NilsBade/AntRig-Measurement-System/PythonChamberApp/figures/Readme/AntRig_ChamberControlTab.png

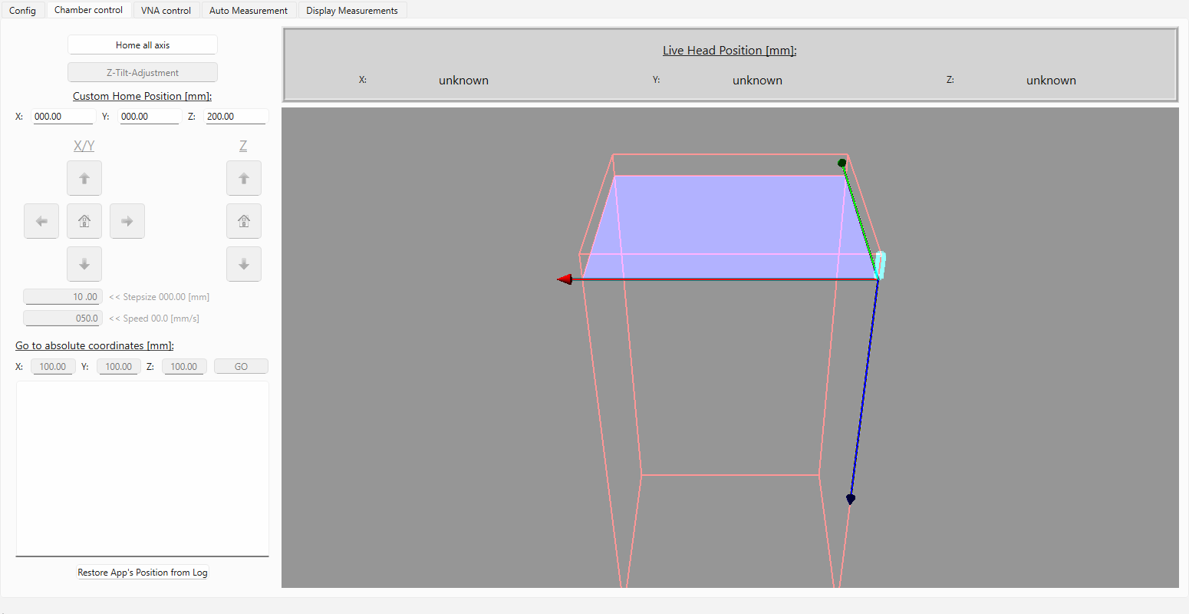
PythonChamberApp/figures/Readme/AntRig_ChamberControlTab.png
