NilsBade/AntRig-Measurement-System/PythonChamberApp/figures/Readme/AntRig_ConfigTab.png

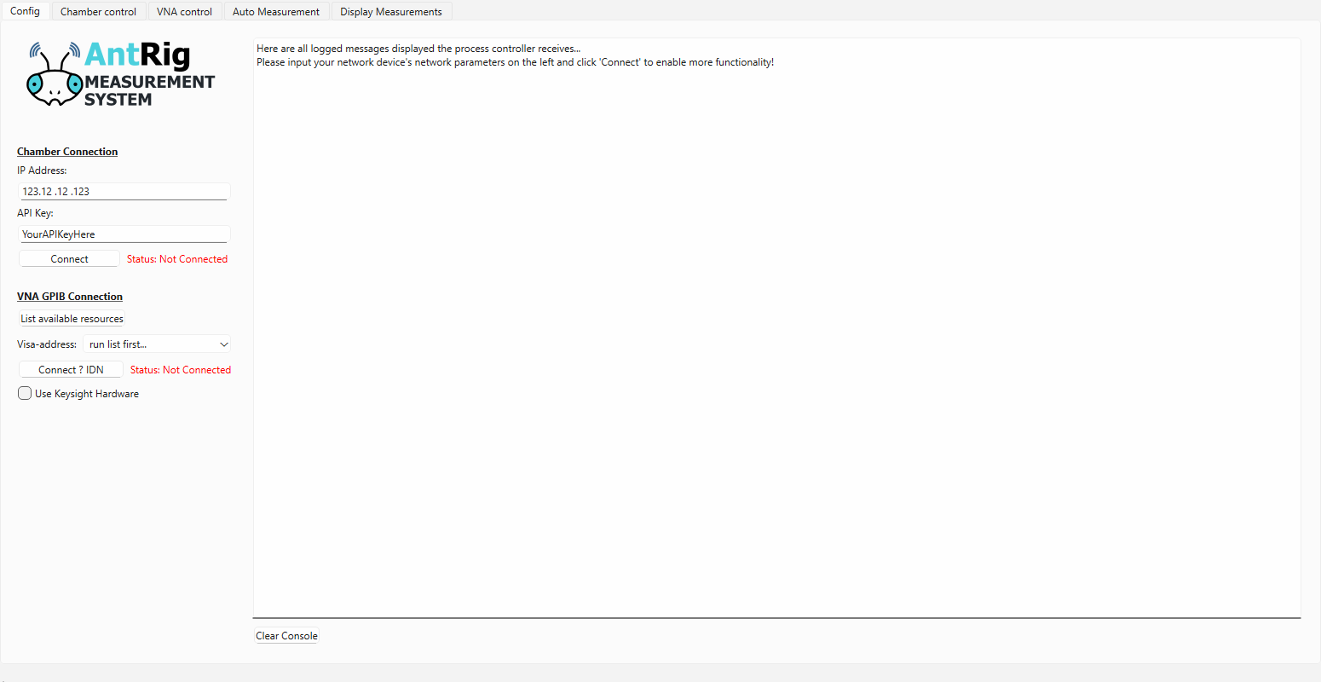
PythonChamberApp/figures/Readme/AntRig_ConfigTab.png
