NilsBade/AntRig-Measurement-System/PythonChamberApp/figures/Readme/AntRig_VNAControlTab.png

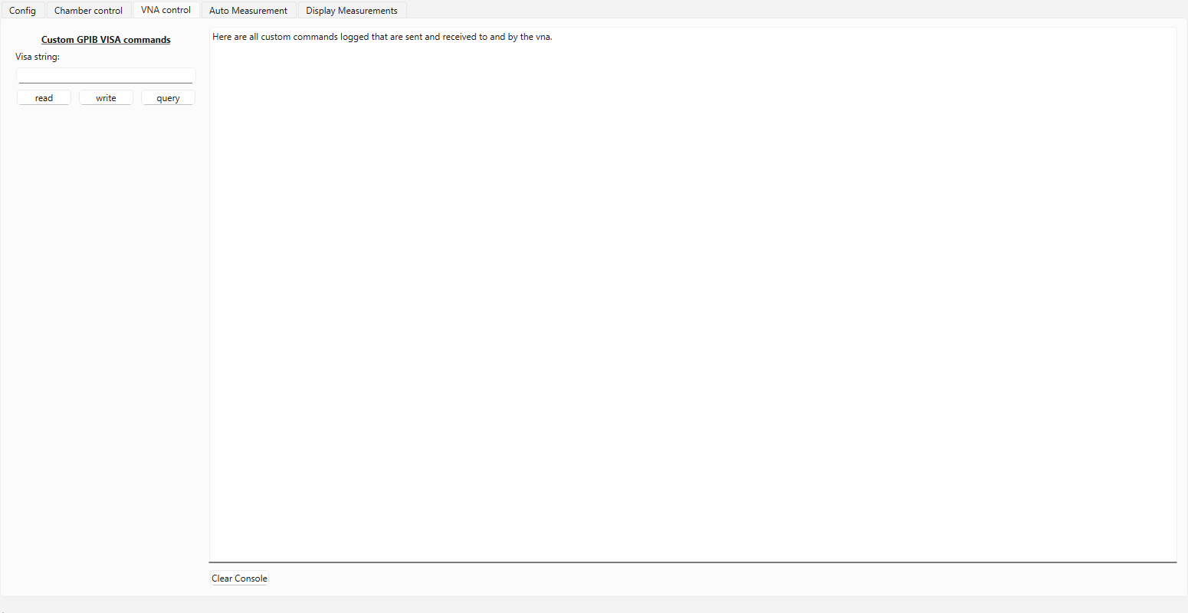
PythonChamberApp/figures/Readme/AntRig_VNAControlTab.png
