NilsBade/AntRig-Measurement-System/docs/BOM/AntRig_Chamber_V1_BOM.xlsx

Sheet: Absorbersurface Calc
Absorber-Installation-Area
 | Position | Number | Area Height [mm] | Area Width [mm] | Total Area [cm^2] |  | For highly directive antenne most crucial
 | Top/Ceiling | 1 | 640 | 640 | 4096
 | Base plate (AUT) | 1 | 530 | 530 | 2809 | *Absorbers must be laid out around AUT
 | X-gantry downside | 1 | 620 | 40 | 248
 | Top L/R | 2 | 230 | 660 | 3036
 | Top Front/Rear | 2 | 230 | 640 | 2944
 | Mid L/R | 2 | 560 | 620 | 6944
 | Mid Front | 1 | 560 | 640 | 3584
 | Bottom L/R | 2 | 560 | 620 | 6944
 | Bottom Front | 1 | 560 | 640 | 3584
 | Rear Panels | 4 | 560 | 300 | 6720
 | Sum of all Areas |  |  |  | 40909 | = [m^2] => | 4.0909

Sheet: Enclosure Order+Postprocessing
Link DXF SVG converter: |  | https://convertio.co/de/dxf-svg/
Postprocessing: |  | Lasercutter, Trotec Speedy SP500 |  | Working Area (W x D): 1245 x 710 [mm2] // Load Area (W x D): 1420 x 820 [mm2]
Panel Dimensions
Height [mm] | Width [mm] | Number used | (Docu) Part Name | Part Location(s)
678 | 710 | 1 | 1* Deckel/Top | Top
326.5 | 628 | 1 | 1* Back Top | Back
541 | 299 | 4 | 4* Back Part (1* modified HF Kabel) | Back
283 | 785 | 2 | 2* SidePanel L/R top | Left/Right
597 | 698 | 4 | 4* SidePanel L/R bottom | Left/Right
283 | 710 | 1 | 1* FrontPanel top | Front
597 | 710 | 2 | 2* FrontPanel bottom | Front
200 | 655 | 1 | 1* E-Panel | Elektronik Panel
Ordering |  |  |  | Postprocessing
Order: PLEXIGLAS® GS orange 3mm (https://www.plattenzuschnitt24.de/Plexiglas-Orange-2H02-GT-3mm.html) |  |  | Parts-Output per panel | SVG File names (Filelocation: *\CAD_and_Manufacturing\Enclosure_LaserCut_SVGs)
565 | 620 | 2 | 2*BackPanel (incl. 1* HF Anpassung)] | 2 SVGs: "1xBackUntenNormal_1xBackUntenHF_565x620","2xBackUntenNormal_565x620"
600 | 805 | 1 | 2* SidePanel L/R top | 1 SVG: "2xSidePanel_Top_LR_600x805"
720 | 1230 | 2 | 2* SidePlanel L/R bottom | 2 SVGs: "2xSidePanel_Bottom_Left_720x1230","2xSidePanel_Bottom_Right_720x1230"
620 | 730 | 2 | 1* FrontPanel bottom | 2 SVGs: "1xFrontPanel_Bottom620_730","1xFrontPanel_Middle_620x730"
700 | 730 | 1 | 1* TopPanel/Ceiling | 1 SVG: "1xTopPanel_700x730"
350 | 650 | 1 | 1* RearPanel Top | 1 SVG: "1xRearTopPanel_350x650"
305 | 730 | 1 | 1* FrontPanel Top | 1 SVG: "1xFrontPanel_Top_305x730"
220 | 675 | 1 | 1* Electronics Panel (Rear) | 1 SVG: "1xElectronicsPanel_220x675"
[mm] | [mm] | number
Enclosure Total Area: | 4.96965 | [m^2]
Cost per m^2: | 68.75 | [€/m^2]
Total Cost: | 341.66 € | EURO

Sheet: RatRig Parts
Order, Feb 2024
 | Part | Number | Price p.P. | Entry Cost | Total Cost: | 782.94 € | Links
1 | ENDSTOP MODULE - HORIZONTAL LIMIT SWITCH ONLY | 4.00 | 1.04 € | 4.16 € |  |  | https://ratrig.com/electronics/probes-limit-switches/endstop-module-horizontal-limit-switch-only.html
2 | BLTOUCH V3.1 - GENUINE ANTCLABS AUTO BED LEVELING SENSOR | 1.00 | 45.00 € | 45.00 € |  |  | https://ratrig.com/bltouch-v3-1.html
3 | ALUMINIUM SPACER - 6MM | 15.00 | 0.25 € | 3.75 € |  |  | https://ratrig.com/aluminium-spacer-6mm.html
4 | BALL BEARING - 695-2RS | 12.00 | 0.79 € | 9.48 € |  |  | https://ratrig.com/ball-bearing-695-2rs.html
5 | BALL BEARING F688ZZ FLANGED 8 X 16 X 5 | 3.00 | 1.06 € | 3.18 € |  |  | https://ratrig.com/ball-bearing-f688zz.html
6 | BALL BEARING - F695ZZ | 24.00 | 1.06 € | 25.44 € |  |  | https://ratrig.com/ball-bearing-f695zz.html
7 | COUPLER - RIGID TYPE - BLACK 25*20MM - 5MM TO 8MM | 2.00 | 3.96 € | 7.92 € |  |  | https://ratrig.com/coupler-rigid-type-black-25-20mm-5mm-to-8mm.html
8 | Bed Plate - Cast tooling plate - Pre-Machined - 529*529*6mm | 1.00 | 132.92 € | 132.92 € |  |  | https://ratrig.com/bed-plate-cast-tooling-plate-pre-machined-multiple-sizes.html
9 | TIMING BELT - 2GT 9MM (BY THE METER) | 6.00 | 2.90 € | 17.40 € |  |  | https://ratrig.com/timing-belt-2gt-9mm-by-the-meter.html
10 | DOWEL PIN - 3.0MM X 35.0MM | 6.00 | 0.42 € | 2.52 € |  |  | https://ratrig.com/dowel-pin-3-0mm-x-35-0mm.html
11 | Lead Screw - TR8*8 Metric Acme Lead Screw - 1057mm | 2.00 | 31.64 € | 63.28 € |  |  | https://ratrig.com/acme-8mm-lead-screw.html
12 | MAGNET - 20 X 10 X 5MM - TWO HOLE (M3 COUNTERSINK SCREWS) | 2.00 | 2.11 € | 4.22 € |  |  | https://ratrig.com/magnet-20-x-10-x-5mm-two-hole-m3-countersink-screws.html
13 | Linear Rail - MGN15 500mm + MGN15C carriage | 2.00 | 36.00 € | 72.00 € |  |  | https://ratrig.com/hardware2/linear-rails/linear-rail-mgn15-mgn15c-carriage.html
14 | Linear Rail - MGN15 1000mm + 2 x MGN15C carriage | 3.00 | 76.77 € | 230.31 € |  |  | https://ratrig.com/hardware2/linear-rails/linear-rail-mgn15-2x-mgn15c-carriage-multiple-lengths.html
15 | MINI PRECISION SHIM - 8 X 5 X 1MM | 35.00 | 0.21 € | 7.35 € |  |  | https://ratrig.com/precision-mini-shim-8x5x1mm.html
16 | Nema 17 Stepper Motor - 48mm - 1.8degree/step, 76oz-in (LDO-42STH48-2504AC) + Cable 2000mm - 4 Conductor 24AWG - JST XH2.54 to JST PH6P (Nema 17 connector) | 4.00 | 17.42 € | 69.68 € |  |  | https://ratrig.com/nema-17-stepper-motor.html
17 | NYLON SPACER - 3MM X 7MM X 5MM | 20.00 | 0.05 € | 1.00 € |  |  | https://ratrig.com/nylon-spacer-3mm-x-7mm-x-5mm.html
18 | RAT RIG BI-MATERIAL LEAD SCREW DECOUPLER | 3.00 | 13.19 € | 39.57 € |  |  | https://ratrig.com/rat-rig-bi-material-lead-screw-decoupler.html
19 | STEEL BALL - 12MM - THREADED M5 | 10.00 | 1.12 € | 11.20 € |  |  | https://ratrig.com/steel-ball-12mm-threaded-m5.html
20 | Thrust Bearing F8-16M | 2.00 | 1.85 € | 3.70 € |  |  | https://ratrig.com/thrust-bearing-f8-16m.html
21 | TIMING PULLEY - 2GT (2MM) - 20 TOOTH - FOR 9MM BELT - 5MM BORE | 2.00 | 3.43 € | 6.86 € |  |  | https://ratrig.com/openbuilds-gt2-2mm-aluminum-timing-pulley-9mm.html
22 | RAT RIG V-CORE 3.1 - WIRING KIT 500 | 1.00 | 22.00 € | 22.00 € |  |  | https://ratrig.com/rat-rig-v-core-3-1-wiring-kit-500.html
23 |  |  | 0.00 € | 0.00 €

Sheet: ITEM Parts
Order, Feb 2024
 | Part | Number | Cost p.P. | Entry Cost | ITEM ID | Total Cost: | 1071.54 € | Links
1 | Universal-Halter | 6.00 | 0.66 € | 3.96 € | 0049452 |  |  | https://www.item24.com/de-de/universal-halter-8-schwarz-49452?velcro=false&fastMounting=true
2 | Befestigungssatz 8 für Lenk-/Bockrolle 140x110 | 12.00 | 1.44 € | 17.28 € | 0067018 |  |  | https://www.item24.com/de-de/befestigungssatz-8-fur-lenk-bockrolle-140x110-67018#description
3 | Winkelsatz 8 40x40 | 11.00 | 6.00 € | 66.00 € | 0041115 |  |  | https://www.item24.com/de-de/winkelsatz-8-40x40-41115
4 | Lenkrolle 140x110 | 4.00 | 38.59 € | 154.36 € | 0066718 |  |  | https://www.item24.com/de-de/lenkrolle-d100-doppelfeststeller-140x110-66718?esd=false
6 | Abdeckkappe 8 40x40 schwarz | 4.00 | 0.63 € | 2.52 € | 0002601 |  |  | https://www.item24.com/de-de/abdeckkappe-8-40x40-schwarz-2601?esd=false
7 | Abdeckkappe 8 80x40 schwarz | 4.00 | 1.04 € | 4.16 € | 0002602 |  |  | https://www.item24.com/de-de/abdeckkappe-8-80x40-schwarz-2602?esd=false
8 | Knotenblechsatz 8 40 120x120 90° | 13.00 | 11.76 € | 152.88 € | 0070802 |  |  | https://www.item24.com/de-de/knotenblechsatz-8-40-120x120-90-70802?outlet=false
9 | Knotenblechsatz 8 40 200x120 180° | 6.00 | 16.40 € | 98.40 € | 0070805 |  |  | https://www.item24.com/de-de/knotenblechsatz-8-40-200x120-180-70805?outlet=false
10 | Kabelführungsprofil 8 40x16 2000mm | 2.00 | 20.43 € | 40.86 € | 0065445 |  |  | https://www.item24.com/de-de/kabelfuhrungsprofil-8-40x16-grau-ahnlich-ral-7042-65444
11 | Nutenstein 8 Zn M3, verzinkt | 100.00 | 0.99 € | 99.00 € | 0037359 |  |  | https://www.item24.com/de-de/nutenstein-8-zn-m3-verzinkt-37359#technical-data
12 | Hammermutter 8 M6, verzinkt | 220.00 | 0.45 € | 99.00 € | 0062606 |  |  | https://www.item24.com/de-de/hammermutter-8-m6-verzinkt-62606?category=profiltechnik&quantity=220
13 | Profil KH 8 80x40 640mm | 2.00 | 17.65 € | 35.30 € | 0065530 |  |  | https://www.item24.com/de-de/profil-kh-8-80x40-anthrazit-65530?length=640
14 | Profil KH 8 80x40 875mm | 2.00 | 22.90 € | 45.80 € | 0065530 |  |  | https://www.item24.com/de-de/profil-kh-8-80x40-anthrazit-65530?length=875
15 | Profil KH 8 40x40 1500mm | 3.00 | 20.86 € | 62.58 € | 0064161 |  |  | https://www.item24.com/de-de/profil-kh-8-40x40-anthrazit-64161?length=1500&category=profiltechnik
16 | Profil KH 8 40x40 715mm | 5.00 | 11.39 € | 56.95 € | 0064161 |  |  | https://www.item24.com/de-de/profil-kh-8-40x40-anthrazit-64161?length=715&category=profiltechnik
17 | Profil KH 8 40x40 640mm | 7.00 | 10.57 € | 73.99 € | 0064161 |  |  | https://www.item24.com/de-de/profil-kh-8-40x40-anthrazit-64161?length=640&category=profiltechnik
18 | Profil KH 8 40x40 1127mm | 2.00 | 16.21 € | 32.42 € | 0064161 |  |  | https://www.item24.com/de-de/profil-kh-8-40x40-anthrazit-64161?length=1127&category=profiltechnik
19 | Profil KH 8 40x40 1087mm | 1.00 | 15.74 € | 15.74 € | 0064161 |  |  | https://www.item24.com/de-de/profil-kh-8-40x40-anthrazit-64161?length=1087&category=profiltechnik
20 | Profil KH 8 40x40 622mm | 1.00 | 10.34 € | 10.34 € | 0064161 |  |  | https://www.item24.com/de-de/profil-kh-8-40x40-anthrazit-64161?length=622&category=profiltechnik
 |  |  | 0.00 € | 0.00 €
 |  |  | 0.00 € | 0.00 €

Sheet: 3D Printed Parts
Order, Feb 2024
 | Source: JLC PCB (https://jlcpcb.com/)
 | Part | Number | Cost p.P. | Entry Cost | Material | Total Cost: | $601.82 | File (Location: *\CAD_and_Manufacturing\3D_Printed_Parts\...)
1 | Base Plate Arm Rear | 1 | $15.04 | $15.04 | ABS |  |  | BedArmBack_x1.stl
2 | Base Plate Arm Left | 1 | $28.88 | $28.88 | ABS |  |  | BedArmLeft_x1.stl
3 | Base Plate Arm Right | 1 | $27.65 | $27.65 | ABS |  |  | BedArmRight_x1.stl
4 | Leadscrew Constraint Front | 2 | $12.67 | $25.34 | ABS |  |  | LeadscrewConstrFront_x2.stl
6 | Leadscrew Constraint Rear | 1 | $8.74 | $8.74 | ABS |  |  | LeadscrewConstrRear_x1.stl
7 | Leadscrew Motorcage Rear | 1 | $43.43 | $43.43 | ABS |  |  | LeadscrewMotorcageBack_x1.stl
8 | Leadscrew Motorcage Front | 2 | $30.71 | $61.42 | ABS |  |  | LeadscrewMotorcageFront_x2.stl
9 | Enclosure Connector Frame - 90deg | 19 | $2.48 | $47.12 | PLA |  |  | MagnetFrame90deg_PLA_x19-26.stl
10 | Enclosure Connector Frame - Straight | 27 | $6.56 | $177.12 | PLA |  |  | MagnetFrameStraight_PLA_x27-51.stl
11 | Enclosure Connector Panel | 46 | $1.50 | $69.00 | 8111X Resin |  |  | MagnetPanelSide_Resin_x46-77.stl
12 | XY Idler Left | 1 | $10.54 | $10.54 | ABS |  |  | XYIdlerLeft_x1.stl
13 | XY Idler Right | 1 | $10.54 | $10.54 | ABS |  |  | XYIdlerRight_x1.stl
14 | XY X-gantry Joiner Left | 1 | $18.59 | $18.59 | ABS |  |  | XYJoinerLeft_x1.stl
15 | XY X-gantry Joiner Right | 1 | $18.58 | $18.58 | ABS |  |  | XYJoinerRight_x1.stl
16 | XY Motorcage Left | 1 | $20.49 | $20.49 | ABS |  |  | XYMotorcageLeft_x1.stl
17 | XY Motorcage Right | 1 | $19.34 | $19.34 | ABS |  |  | XYMotorcageRight_x1.stl
18 |  |  |  | $0.00
19 |  |  |  | $0.00
20 |  |  |  | $0.00
21 |  |  |  | $0.00
 |  |  |  | $0.00
 | Source: Own Manufacturing
 | Part | Number | Cost p.P. | Entry Cost | Material | Total Cost: | 0.00 € | File (Location: *\CAD_and_Manufacturing\3D_Printed_Parts\...)
1 | Core XY belt grabber | 2.00 | 0.00 € | 0.00 € | PLA |  |  | export from overall step
2 | Probe head | 1.00 | 0.00 € | 0.00 € | Clear Resin |  |  | export from overall step
3 | Schraubenhalter (Screw Holder) | 1.00 | 0.00 € | 0.00 € | PLA |  |  | export from overall step
4 | Modulhalter | 2.00 | 0.00 € | 0.00 € | PLA |  |  | export from overall step
6 | HF Cable bushing rear (base + top) | 1.00 | 0.00 € | 0.00 € | Resin |  |  | export from overall step
7 | HF Cable bushing top (base + top) | 1.00 | 0.00 € | 0.00 € | Resin |  |  | export from overall step
8 | X-limit-switch Fixture | 1.00 | 0.00 € | 0.00 € | PLA/Resin |  |  | export from overall step
9 | Y-limit-switch Fixture (2 parts) | 1.00 | 0.00 € | 0.00 € | PLA/Resin |  |  | export from overall step
10 | Probe head module plate BL-Touch | 1.00 | 0.00 € | 0.00 € | PLA |  |  | export from overall step
11 | BL-Touch Plug/Connector fixture | 1.00 | 0.00 € | 0.00 € | PLA/Resin |  |  | export from overall step
12 |  |  | 0.00 € | 0.00 €
13 |  |  | 0.00 € | 0.00 €
14 |  |  | 0.00 € | 0.00 €
15 |  |  | 0.00 € | 0.00 €
16 |  |  | 0.00 € | 0.00 €
17 |  |  | 0.00 € | 0.00 €
18 |  |  | 0.00 € | 0.00 €
19 |  |  | 0.00 € | 0.00 €
20 |  |  | 0.00 € | 0.00 €
21 |  |  | 0.00 € | 0.00 €
 |  |  | 0.00 € | 0.00 €

Sheet: Standard Parts
Order, Feb 2024
 | Part | Required Number | Pack Size | Number Packs | Cost p. Pack | Entry Cost | Part ID | Total Cost: | 293.54 € | Links
1 | DIN912 M3x8 | 32.00 | 100.00 | 1.00 | 9.97 € | 9.97 € | 2534-278 |  |  | DIN912, V2A Schrauben (https://www.wegertseder.com/DIN-912-Zylinderschrauben-mit-Innensechskant-ROSTFREI-A2)
2 | DIN912 M3x12 | 135.00 | 100.00 | 2.00 | 11.97 € | 23.94 € | 2534-282
3 | DIN912 M3x18 | 12.00 | 100.00 | 1.00 | 7.09 € | 7.09 € | 2534-288
4 | DIN912 M3x20 | 8.00 | 100.00 | 1.00 | 12.28 € | 12.28 € | 2534-290
5 | DIN912 M3x35 | 8.00 | 50.00 | 1.00 | 13.99 € | 13.99 € | 2534-298
6 | DIN912 M4x8 | 55.00 | 100.00 | 1.00 | 13.98 € | 13.98 € | 2534-314
7 | DIN912 M4x12 | 10.00 | 100.00 | 1.00 | 12.48 € | 12.48 € | 2534-318
8 | DIN912 M5x40 | 8.00 | 50.00 | 1.00 | 13.19 € | 13.19 € | 2534-382
9 | DIN912 M5x50 | 2.00 | 20.00 | 1.00 | 9.63 € | 9.63 € | 2534-388
10 | DIN912 M5x60 | 4.00 | 10.00 | 1.00 | 5.53 € | 5.53 € | 2534-394
11 | DIN 912 M6x12 | 175 | 500.00 | 1.00 | 41.83 € | 41.83 € | 2534-418
12 | DIN 912 M6x16 | 171 | 200.00 | 1.00 | 29.06 € | 29.06 € | 2534-422
13 | DIN 912 M6x20 | 9 | 50.00 | 1.00 | 15.09 € | 15.09 € | 2534-426
 |  |  |  |  | 0.00 € | 0.00 €
14 | DIN 7991 M3x12 | 6 | 100.00 | 1.00 | 9.46 € | 9.46 € | 2608-686 |  |  | DIN 7991 Senkschrauben V2A (https://www.wegertseder.com/DIN-7991-Senkschrauben-mit-Innensechskant-ROSTFREI-A2)
15 | DIN 7991 M5x16 | 3 | 50.00 | 1.00 | 7.70 € | 7.70 € | 2608-746
16 | DIN 7991 M6x14 | 12 | 25.00 | 1.00 | 7.32 € | 7.32 € | 2608-778
 |  |  |  |  | 0.00 € | 0.00 €
17 | DIN125 M3 Washer | 18 | 200.00 | 1.00 | 8.09 € | 8.09 € | 1498-294 |  |  | DIN 125 Unterlegscheiben (https://www.wegertseder.com/DIN-125-Unterlegscheiben-Form-A-bei-Stahl-Klasse-140-HV-ROSTFREI-A2)
18 | DIN125 M6 Washer | 170 | 100.00 | 2.00 | 5.36 € | 10.72 € | 1498-302
 |  |  |  |  | 0.00 € | 0.00 €
19 | DIN985 M3 | 18 | 100.00 | 1.00 | 9.52 € | 9.52 € | 3346-232 |  |  | DIN985 Locking Nuts (https://www.wegertseder.com/DIN-985-Sechskantmuttern-Polyamidklemmteil-niedrige-Form-ROSTFREI-A2)
20 | DIN985 M5 | 74 | 100.00 | 1.00 | 13.13 € | 13.13 € | 3346-236
21 | DIN985 M6 | 154 | 100.00 | 2.00 | 9.77 € | 19.54 € | 3346-238
 |  |  |  |  | 0.00 € | 0.00 €
 |  |  |  |  | 0.00 € | 0.00 €

Sheet: Misc Parts
Order, Feb 2024
 | Part | Number | Cost p.P. | Entry Cost | Total Cost: | 222.46 € | Links
1 | Raspberry Pi 4 B, 2GB Memory | 1.00 |  | 0.00 € |  |  | Conrad (https://www.conrad.de/de/p/raspberry-pi-4-b-2-gb-4-x-1-5-ghz-raspberry-pi-2138863.html?insert=VQ)
2 | BTT Octopus V1.1 Motherboard | 1.00 | 72.36 € | 72.36 € |  |  | RatRig (https://ratrig.com/products/btt-octopus-v1-1-motherboard-1)
3 | POWER SUPPLY - MEANWELL RSP 75W 24V | 1.00 | 33.88 € | 33.88 € |  |  | Mouser (https://www.mouser.de/ProductDetail/MEAN-WELL/RSP-75-24?qs=JK6Bpmia%2FmvYBMpiosaujw%3D%3D)
4 | Neodymium disc magnet 10 mm diameter, 4 mm height | 298.00 | 0.39 € | 116.22 € |  |  | Gauder (https://gauder.net/en/products/neodym-scheibenmagnet-10-mm-x-4-mm)
5 |  |  | 0.00 € | 0.00 €
6 |  |  | 0.00 € | 0.00 €
 |  |  | 0.00 € | 0.00 €
 |  |  | 0.00 € | 0.00 €
