NilsBade/AntRig-Measurement-System/CAD_and_Manufacturing/3D_Printed_Parts/XYIdlerRight_x1.stl

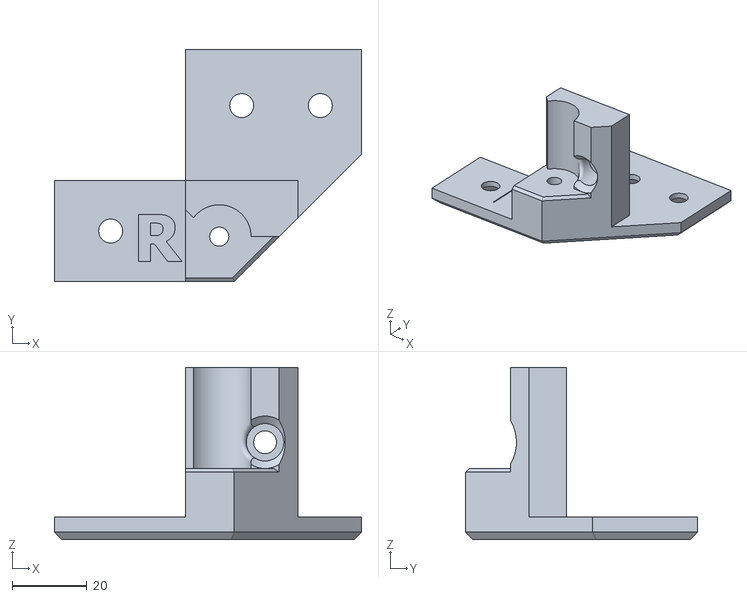
[picture p9: CAD file, 2026-02-20]
CAD_and_Manufacturing/3D_Printed_Parts/XYIdlerRight_x1.stl
82.0 x 62.0 x 46.0
