NilsBade/AntRig-Measurement-System/CAD_and_Manufacturing/Enclosure_LaserCut_SVGs/DXFs/Unten Rear HFAussparung.dxf

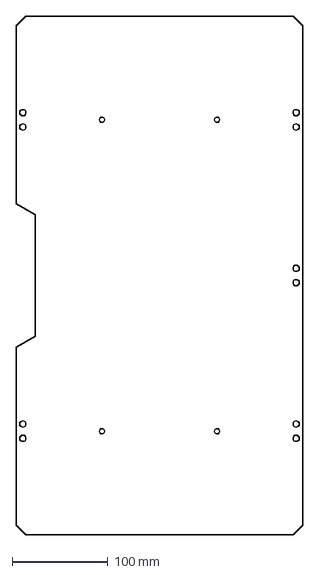
[picture p10: CAD file, 2026-02-20]
CAD_and_Manufacturing/Enclosure_LaserCut_SVGs/DXFs/Unten Rear HFAussparung.dxf
299.0 x 541.0 mm
