NilsBade/AntRig-Measurement-System/CAD_and_Manufacturing/Enclosure_LaserCut_SVGs/DXFs/Unten Links_Rechts.dxf

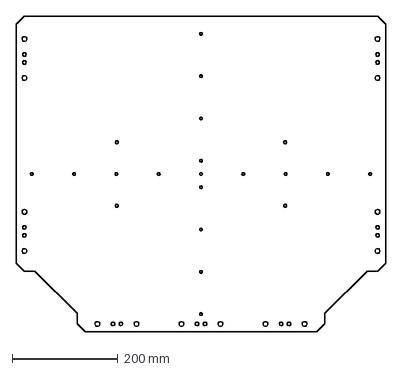
[picture p12: CAD file, 2026-02-20]
CAD_and_Manufacturing/Enclosure_LaserCut_SVGs/DXFs/Unten Links_Rechts.dxf
698.0 x 597.0 mm
