NilsBade/AntRig-Measurement-System/CAD_and_Manufacturing/Enclosure_LaserCut_SVGs/DXFs/Top Rear.dxf

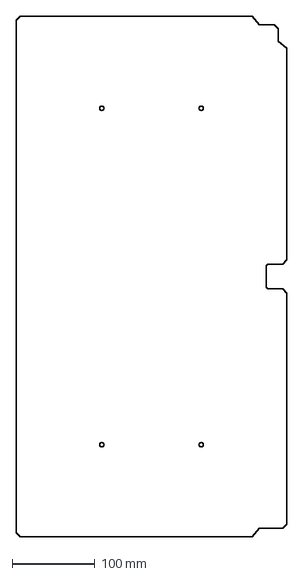
[picture p13: CAD file, 2026-02-20]
CAD_and_Manufacturing/Enclosure_LaserCut_SVGs/DXFs/Top Rear.dxf
326.5 x 628.0 mm
