NilsBade/AntRig-Measurement-System/CAD_and_Manufacturing/3D_Printed_Parts/BedArmRight_x1.stl

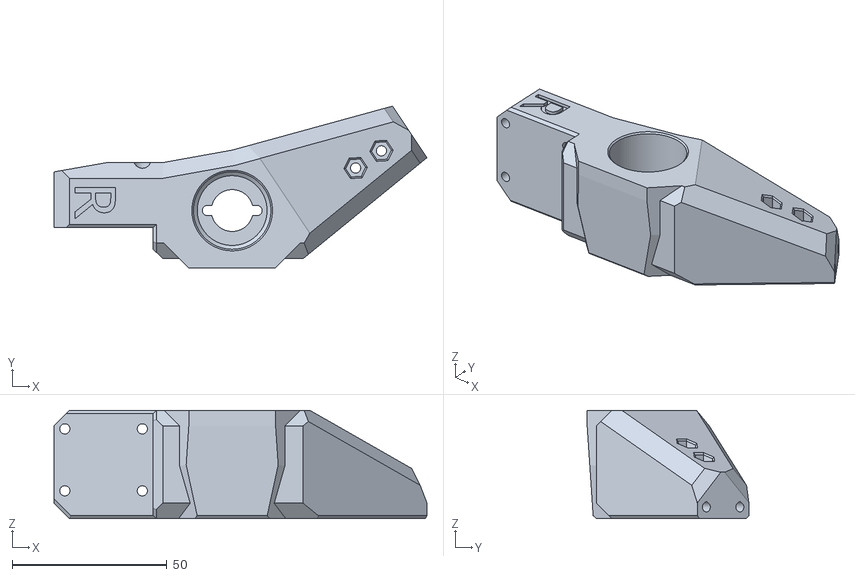
[picture p14: CAD file, 2026-02-20]
CAD_and_Manufacturing/3D_Printed_Parts/BedArmRight_x1.stl
120.4 x 52.2 x 35.0
