NilsBade/AntRig-Measurement-System/CAD_and_Manufacturing/Enclosure_LaserCut_SVGs/DXFs/Top Deckel.dxf

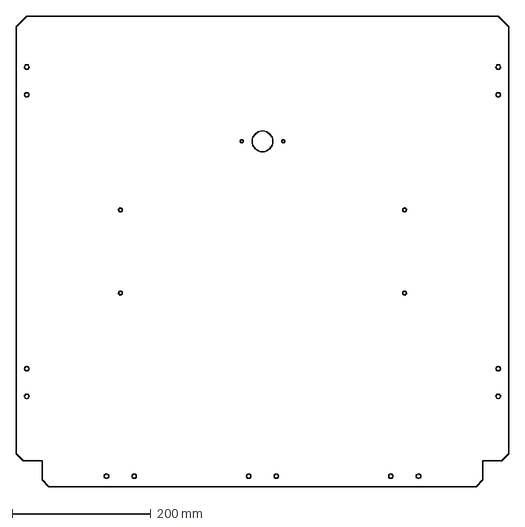
[picture p15: CAD file, 2026-02-20]
CAD_and_Manufacturing/Enclosure_LaserCut_SVGs/DXFs/Top Deckel.dxf
710.0 x 678.0 mm
