NilsBade/AntRig-Measurement-System/CAD_and_Manufacturing/Enclosure_LaserCut_SVGs/DXFs/Unten Rear Normal.dxf

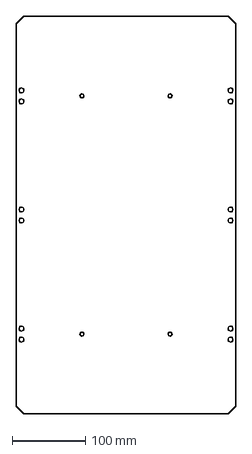
[picture p16: CAD file, 2026-02-20]
CAD_and_Manufacturing/Enclosure_LaserCut_SVGs/DXFs/Unten Rear Normal.dxf
299.0 x 541.0 mm
