NilsBade/AntRig-Measurement-System/CAD_and_Manufacturing/3D_Printed_Parts/MagnetFrame90deg_PLA_x19-26.stl

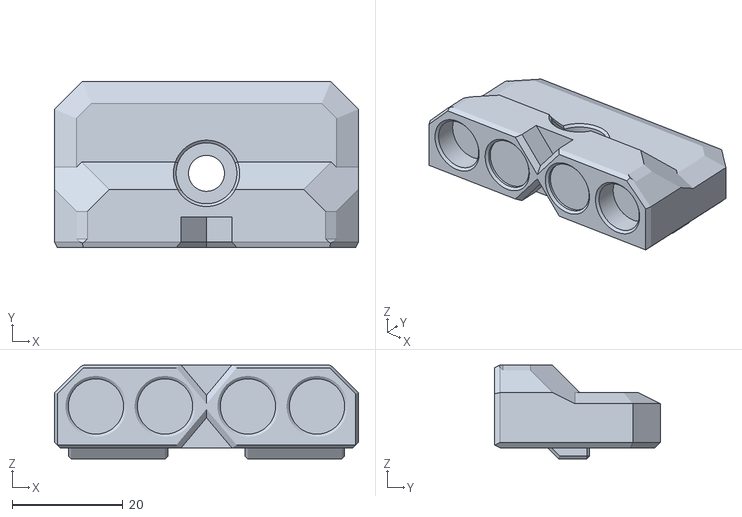
[picture p17: CAD file, 2026-02-20]
CAD_and_Manufacturing/3D_Printed_Parts/MagnetFrame90deg_PLA_x19-26.stl
55.0 x 30.0 x 17.0
