NilsBade/AntRig-Measurement-System/CAD_and_Manufacturing/3D_Printed_Parts/MagnetFrameStraight_PLA_x27-51.stl

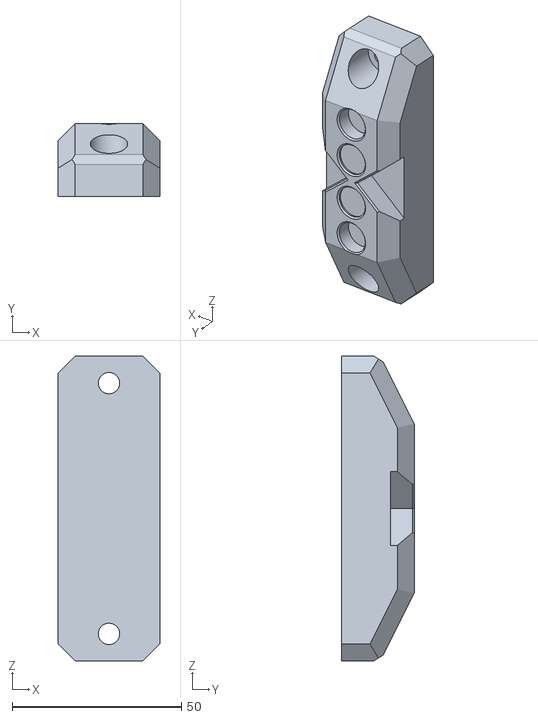
[picture p20: CAD file, 2026-02-20]
CAD_and_Manufacturing/3D_Printed_Parts/MagnetFrameStraight_PLA_x27-51.stl
30.0 x 21.4 x 90.0
