NilsBade/AntRig-Measurement-System/CAD_and_Manufacturing/3D_Printed_Parts/BedArmBack_x1.stl

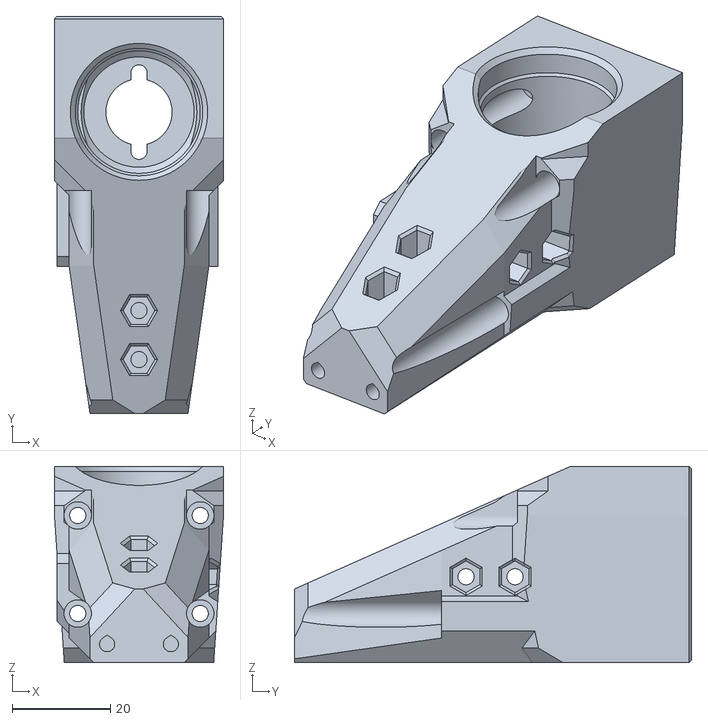
[picture p22: CAD file, 2026-02-20]
CAD_and_Manufacturing/3D_Printed_Parts/BedArmBack_x1.stl
34.5 x 81.0 x 40.0
