NilsBade/AntRig-Measurement-System/CAD_and_Manufacturing/3D_Printed_Parts/MagnetPanelSide_Resin_x46-77.stl

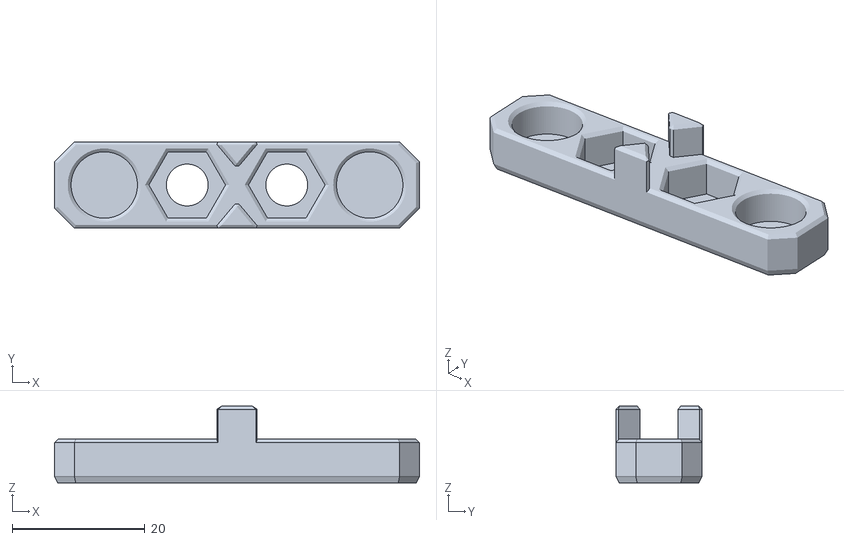
[picture p24: CAD file, 2026-02-20]
CAD_and_Manufacturing/3D_Printed_Parts/MagnetPanelSide_Resin_x46-77.stl
55.0 x 13.0 x 11.6
