NilsBade/AntRig-Measurement-System/CAD_and_Manufacturing/3D_Printed_Parts/XYJoinerRight_x1.stl

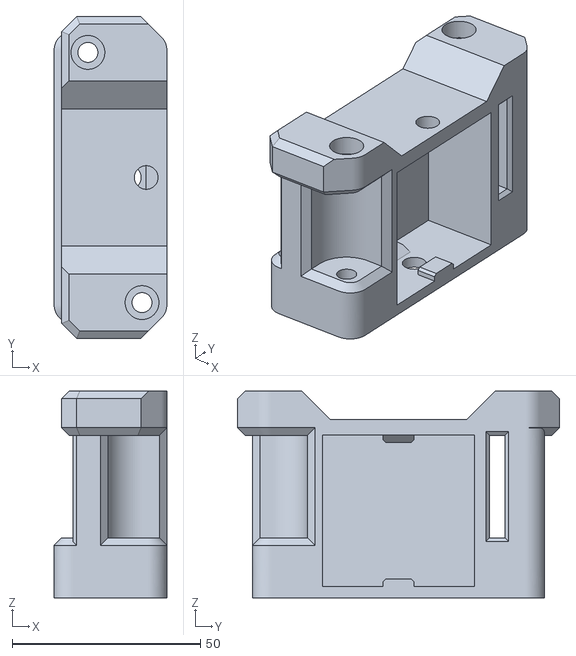
[picture p25: CAD file, 2026-02-20]
CAD_and_Manufacturing/3D_Printed_Parts/XYJoinerRight_x1.stl
30.0 x 85.6 x 55.0
