NilsBade/AntRig-Measurement-System/CAD_and_Manufacturing/3D_Printed_Parts/XYMotorcageRight_x1.stl

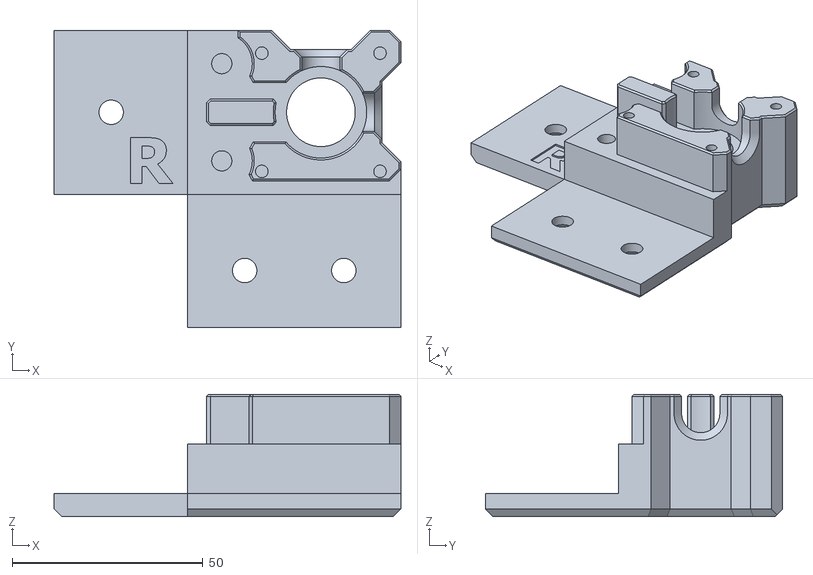
[picture p26: CAD file, 2026-02-20]
CAD_and_Manufacturing/3D_Printed_Parts/XYMotorcageRight_x1.stl
91.0 x 78.0 x 32.0
