NilsBade/AntRig-Measurement-System/CAD_and_Manufacturing/3D_Printed_Parts/XYJoinerLeft_x1.stl

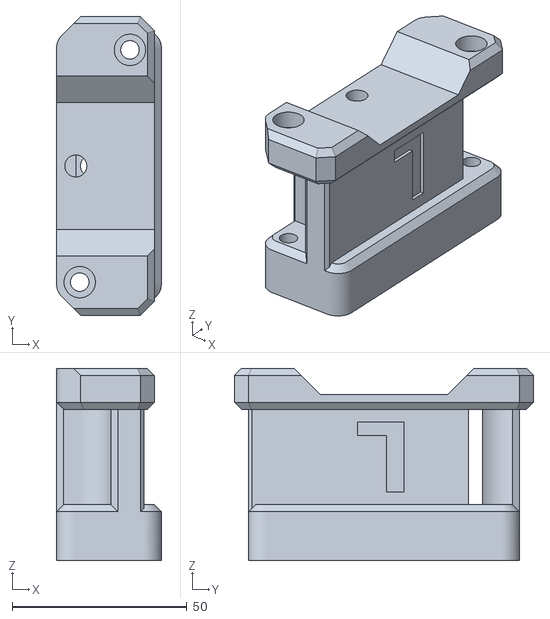
[picture p27: CAD file, 2026-02-20]
CAD_and_Manufacturing/3D_Printed_Parts/XYJoinerLeft_x1.stl
30.0 x 85.6 x 55.0
