NilsBade/AntRig-Measurement-System/(list of files, cad)

Other CAD files:
CAD_and_Manufacturing/3D_Printed_Parts/BedArmLeft_x1.stl
CAD_and_Manufacturing/3D_Printed_Parts/XYIdlerLeft_x1.stl
CAD_and_Manufacturing/3D_Printed_Parts/LeadscrewConstrFront_x2.stl
CAD_and_Manufacturing/3D_Printed_Parts/LeadscrewConstrRear_x1.stl
CAD_and_Manufacturing/3D_Printed_Parts/LeadscrewMotorcageBack_x1.stl
CAD_and_Manufacturing/3D_Printed_Parts/LeadscrewMotorcageFront_x2.stl
