NilsBade/AntRig-Measurement-System/PythonChamberApp/figures/Readme/AntRig_AutoMeasurementTab.png

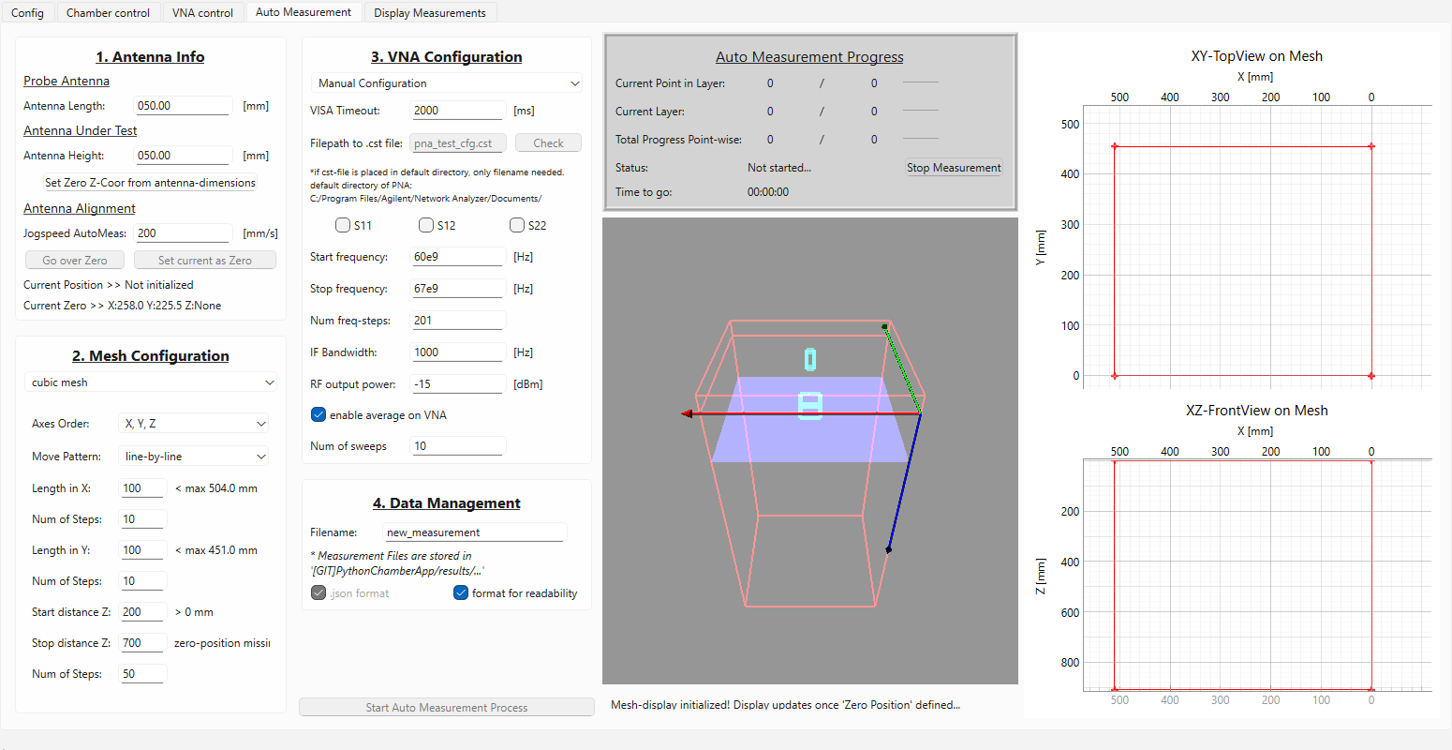
PythonChamberApp/figures/Readme/AntRig_AutoMeasurementTab.png
