NilsBade/AntRig-Measurement-System/PythonChamberApp/figures/Readme/AntRig_DisplayMeasurementsTab.png

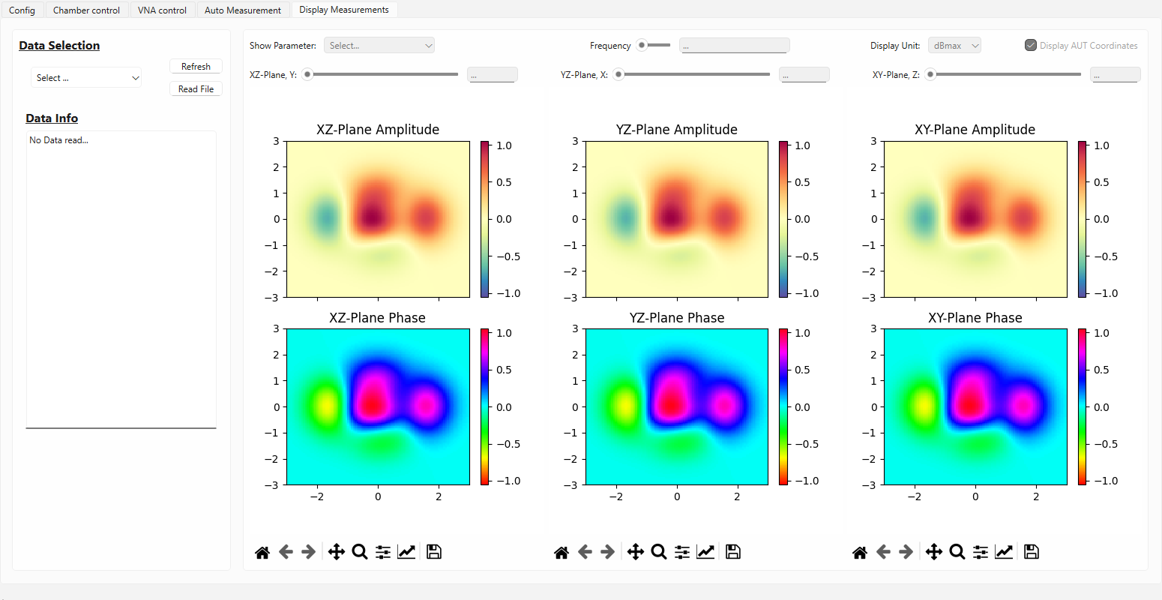
PythonChamberApp/figures/Readme/AntRig_DisplayMeasurementsTab.png
