NilsBade/AntRig-Measurement-System/CAD_and_Manufacturing/Technical_Drawings/BasePlateDrawing.pdf

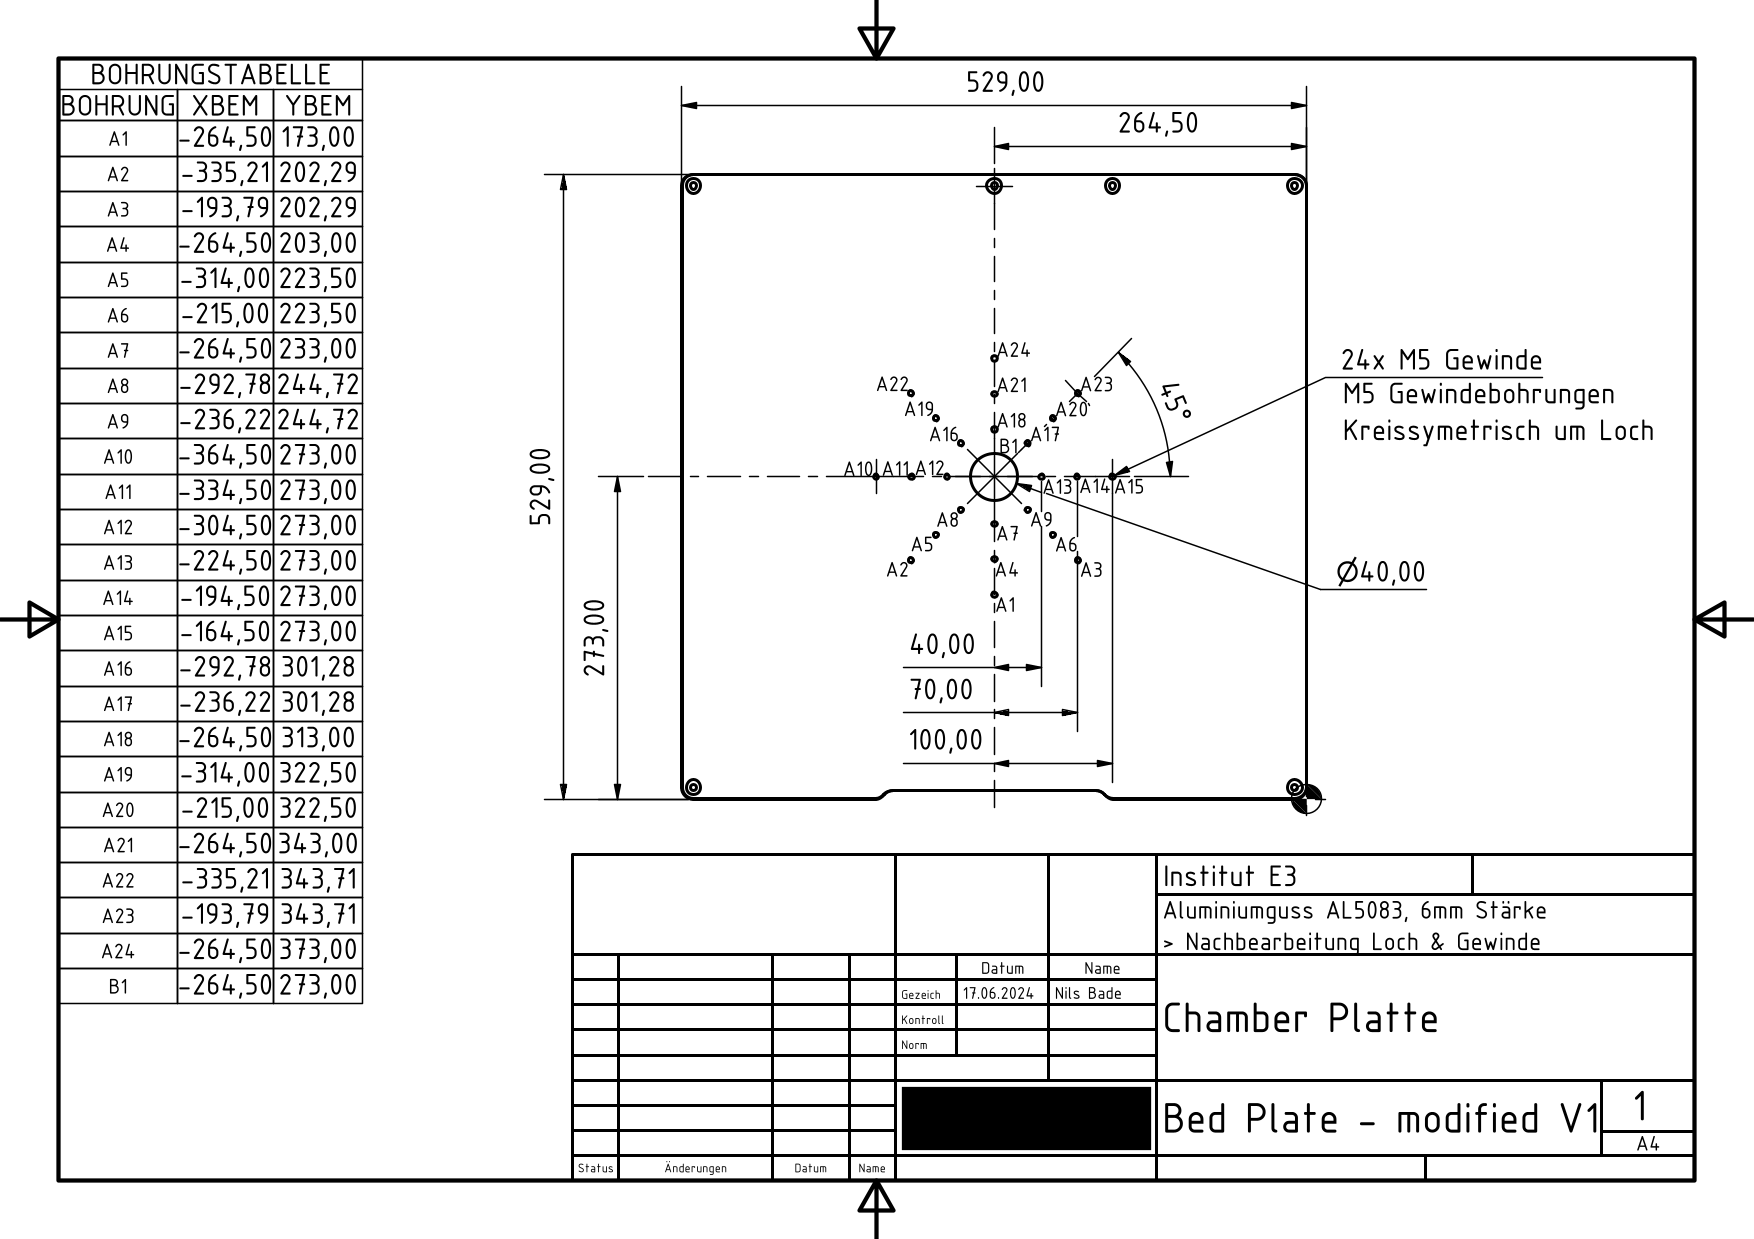
[picture p30: page 1]
