NilsBade/AntRig-Measurement-System/CAD_and_Manufacturing/Technical_Drawings/IdlerPlateDrawing.pdf

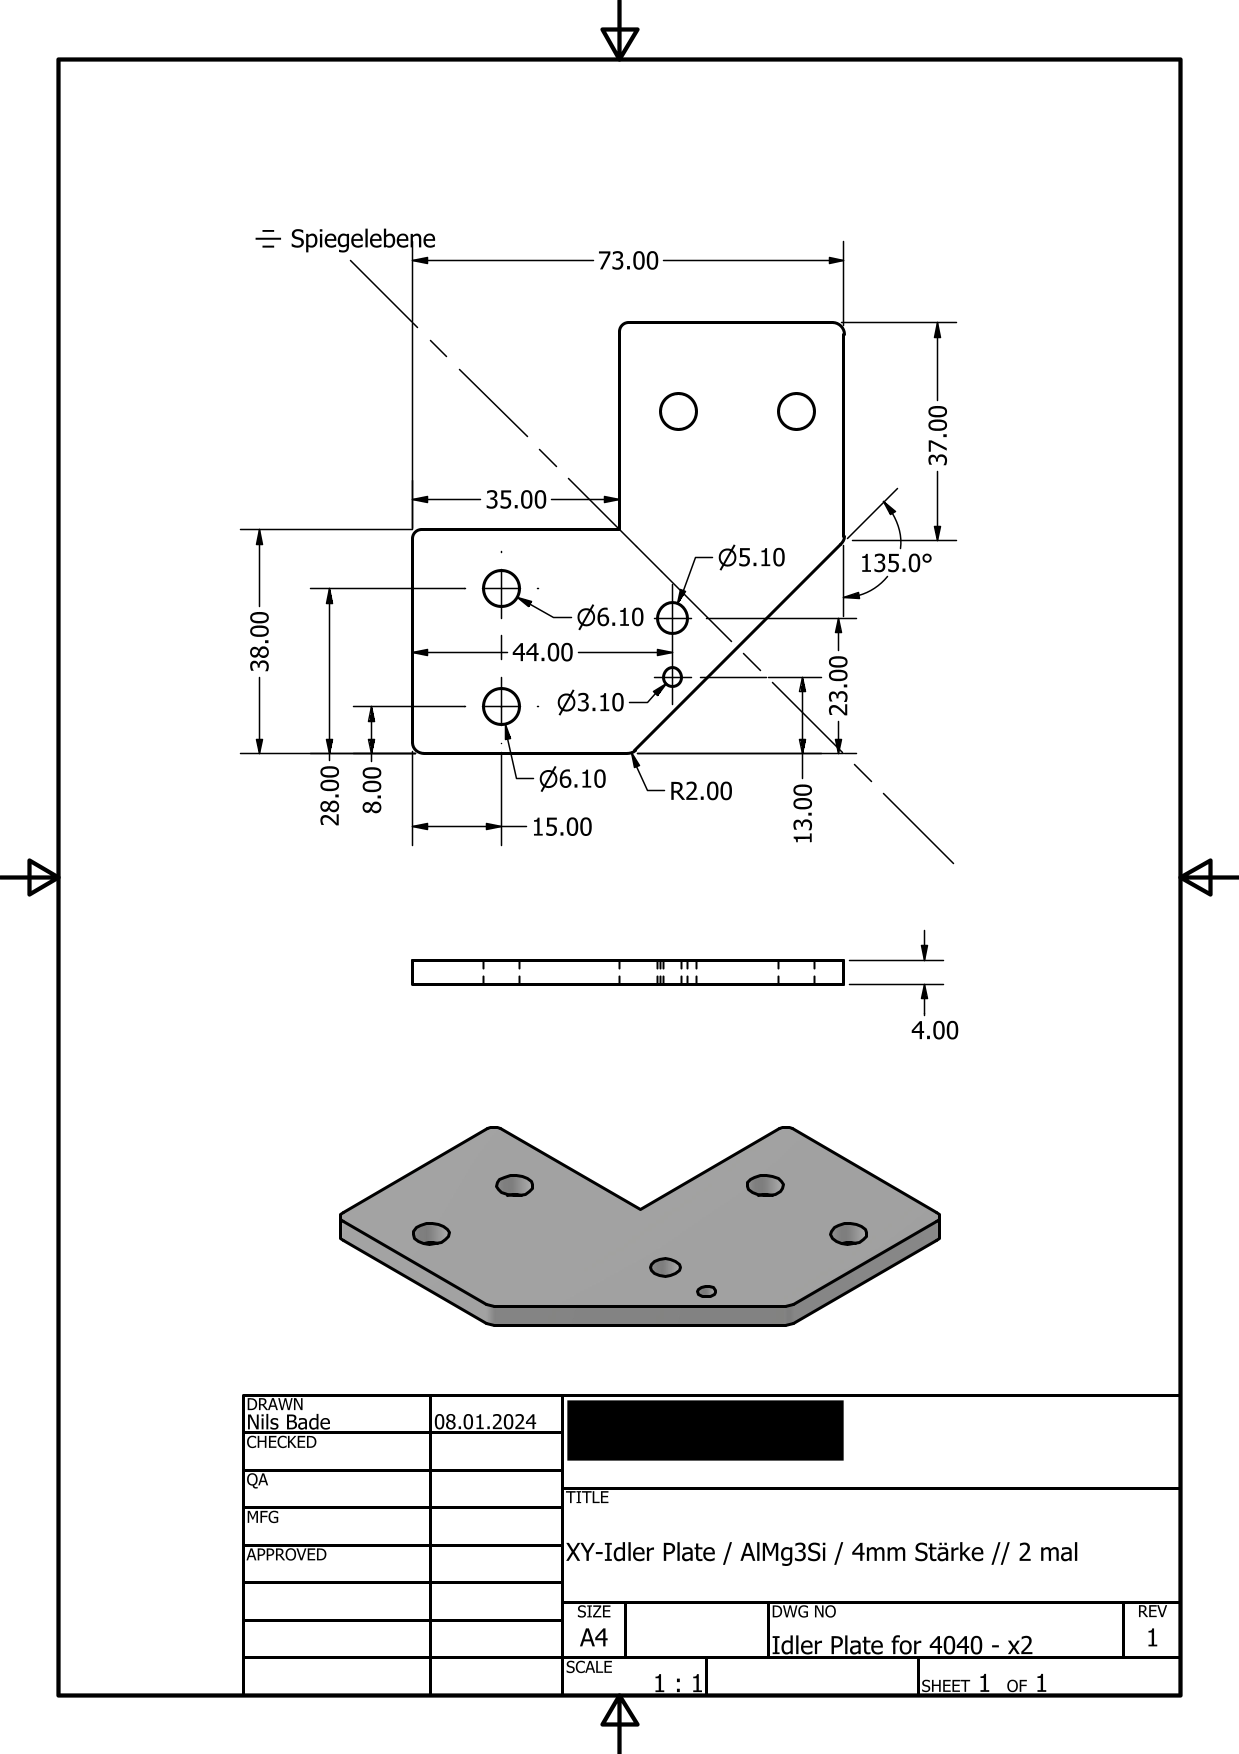
[picture p31: page 1]
