NilsBade/AntRig-Measurement-System/CAD_and_Manufacturing/Technical_Drawings/RollBaseConnectorPlateDrawing.pdf

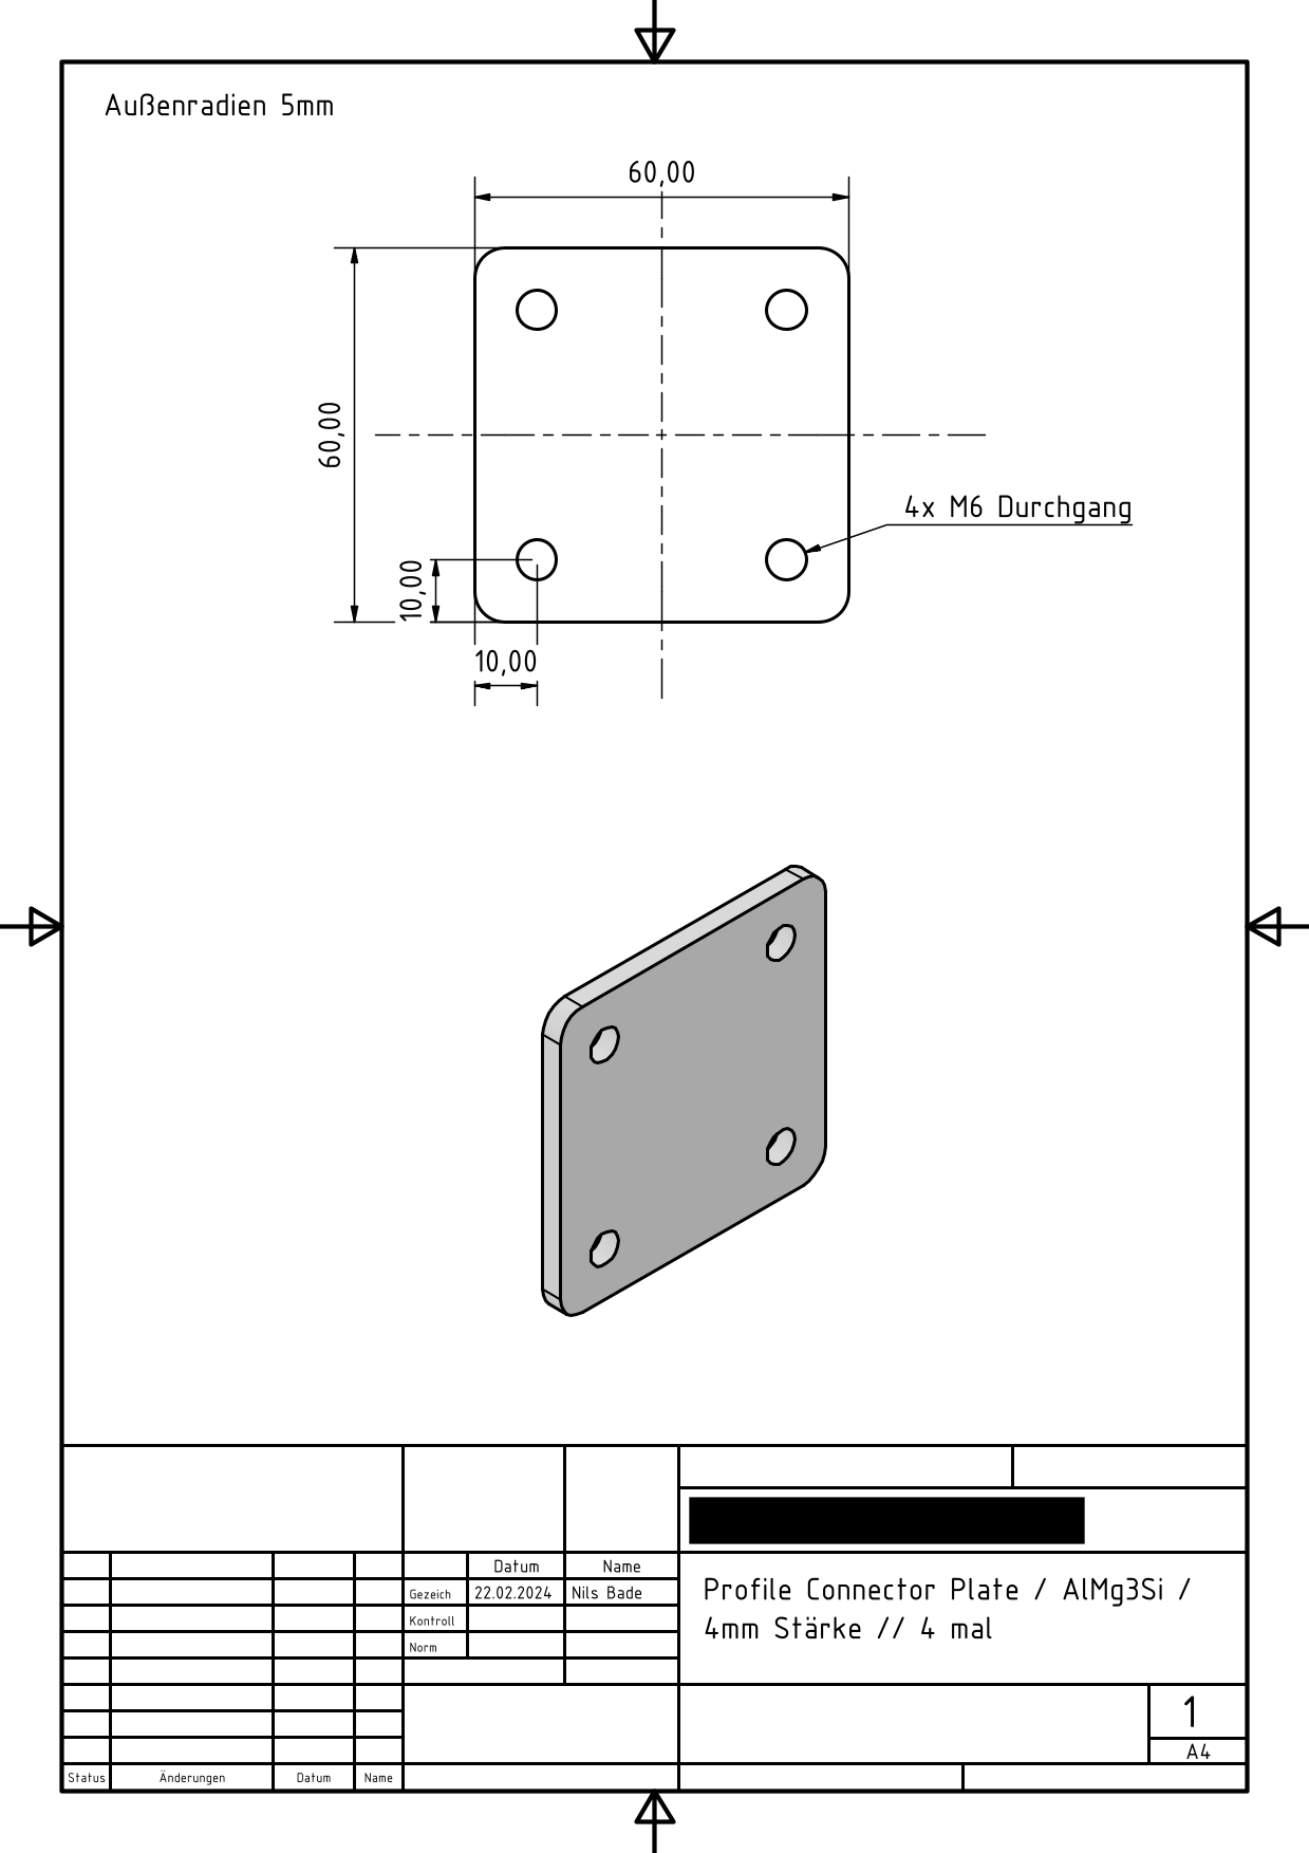
[picture p32: page 1]
