NilsBade/AntRig-Measurement-System/CAD_and_Manufacturing/Technical_Drawings/XYJoinerPlateDrawing.pdf

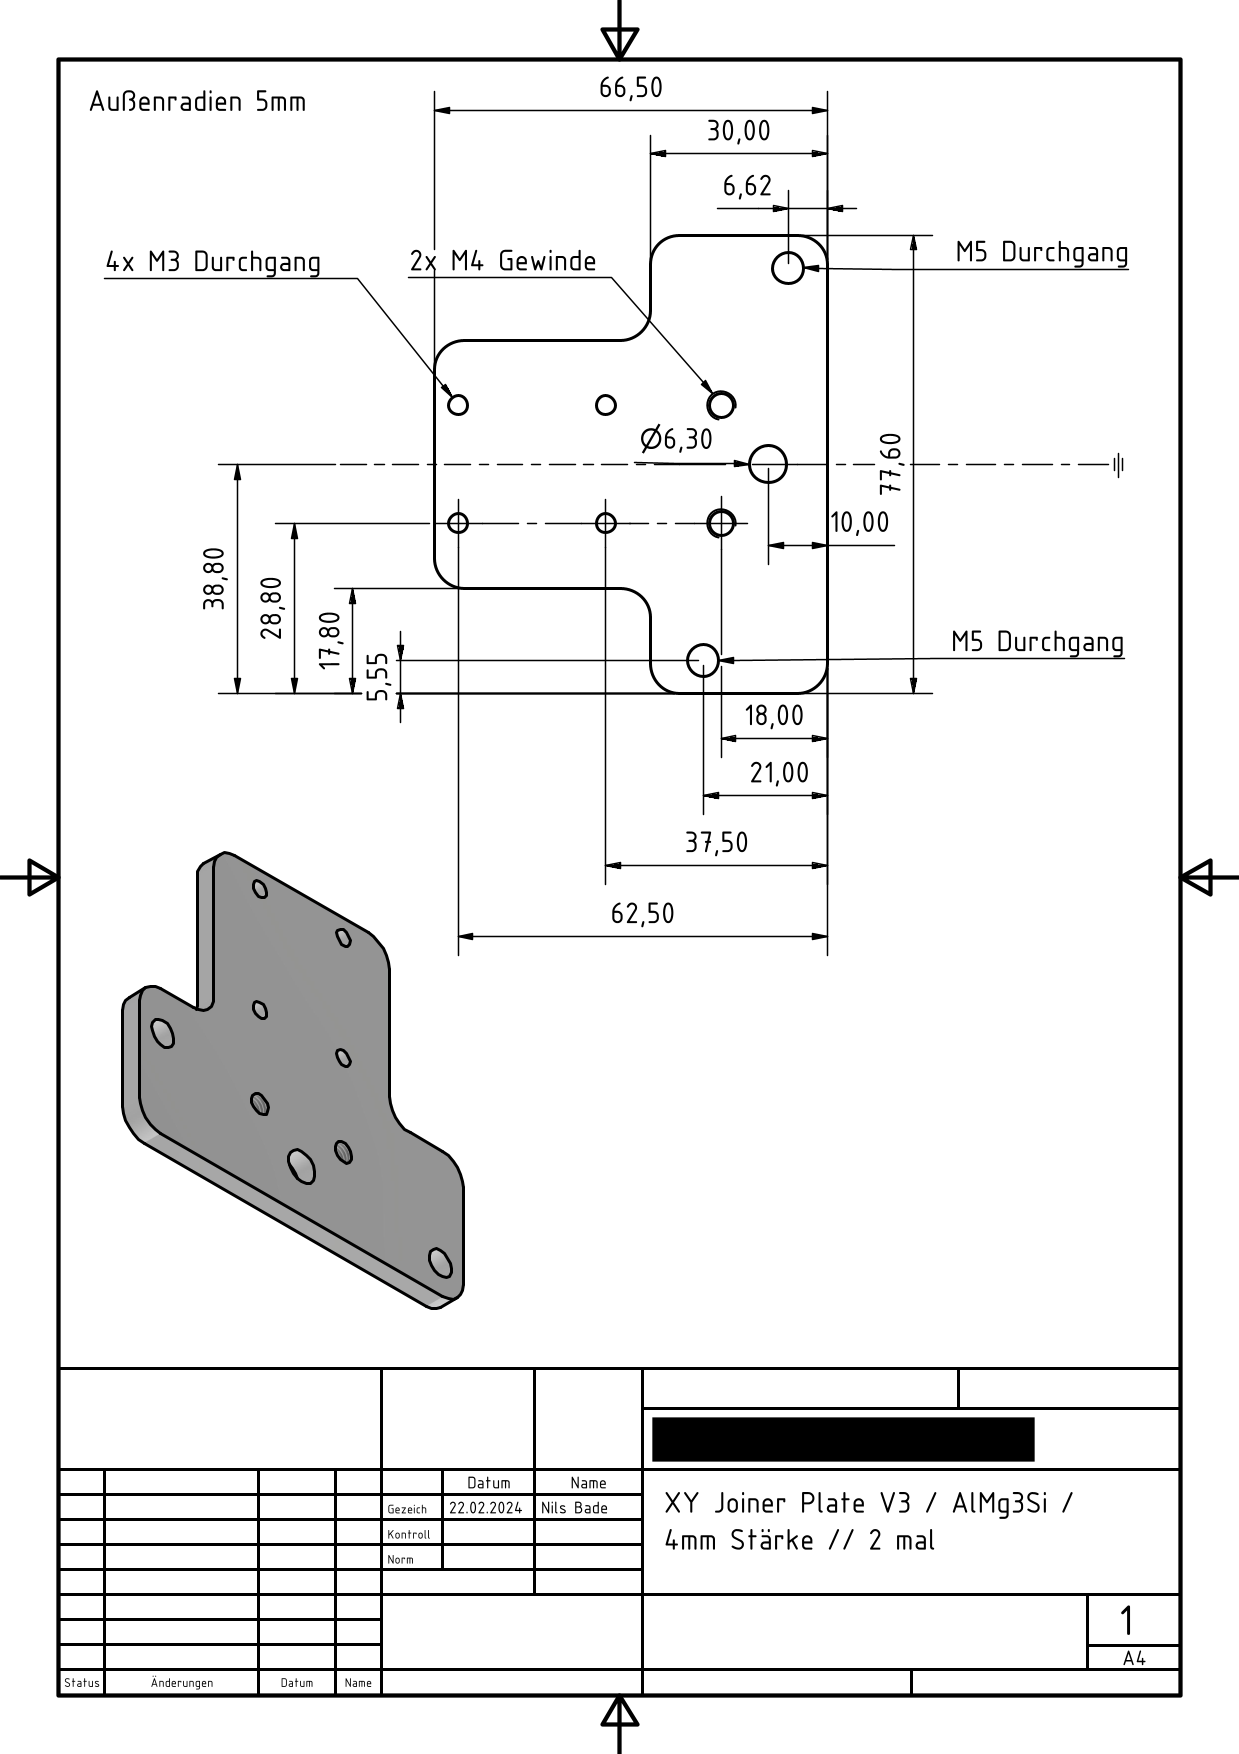
[picture p33: page 1]
