NilsBade/AntRig-Measurement-System/CAD_and_Manufacturing/Technical_Drawings/XYMotorPlateDrawing.pdf

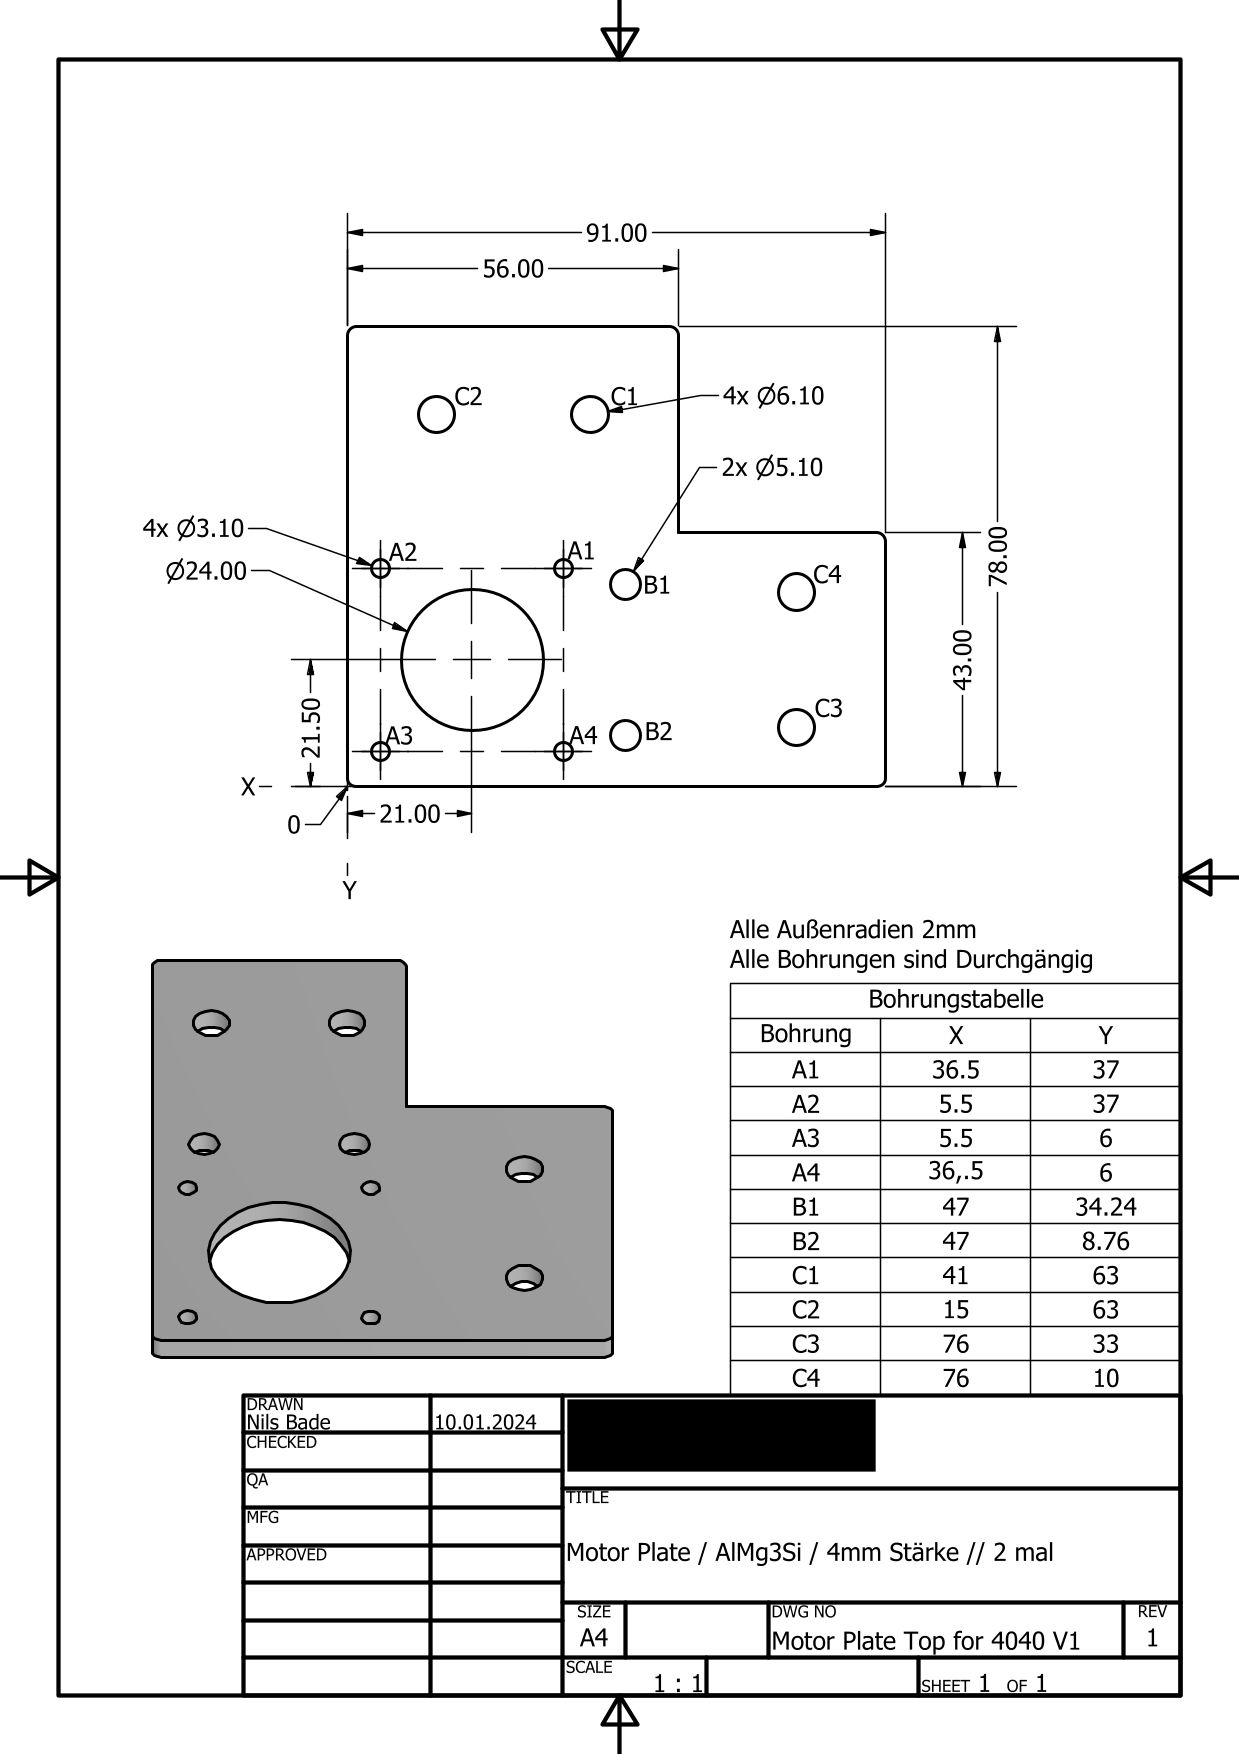
[picture p34: page 1]
