NilsBade/AntRig-Measurement-System/(commit log)

2026-02-20 Initial Release AntRig-Measurement-System 2.0
    [AntRig_Chamber_V1_BOM.xlsx, AntRig_V1_printer.cfg, BedArmBack_x1.stl, BedArmLeft_x1.stl, BedArmRight_x1.stl, E_Panel.dxf, LeadscrewConstrFront_x2.stl, LeadscrewConstrRear_x1.stl]
2026-02-25 updated BOM with raspberry and octoprint motherboard
    [AntRig_Chamber_V1_BOM.xlsx]
